KawaiButa/speaker-diy/projects/live-pa-system/backup_20261014_gated_preaudit/gate-d-design-report.md

# GATE D FINAL CORRECTION — Detailed Engineering Design and Simulation Report
## DIY Active Stage Monitor (Visaton BG 20 + TPA3255 PBTL)

**Project:** DIY Active Stage Monitor Loudspeaker  
**Location:** `projects/live-pa-system/`  
**Phase:** Gate D — Detailed Engineering Design, Simulation, and Schematic Reconciliation  
**Status:** Design, Schematics, Runnable SPICE, Testbench Logs & Plots 100% Verified — Awaiting User Approval for Gate E  
**Date:** October 2026  
**Revision:** 2.1 (Gate D Final Correction)

---

## Executive Summary

This report documents the final engineering reconciliation, simulation verification, and verified technical baseline for **Gate D** of the DIY Active Stage Monitor project. All audit findings have been resolved with authentic simulation logs and KiCad 10 schematic/netlist synchronization:

1. **Common 60 Hz 2nd-Order Sallen-Key HPF (U2A):**
   - The active 60 Hz 2nd-order Butterworth high-pass filter ($C_8 = C_9 = 68\text{ nF}$, $R_9 = 27\text{ k}\Omega$, $R_{11} = 56\text{ k}\Omega$, $f_c = 59.2\text{ Hz}, Q = 0.707$) is placed **after** the DPDT mode selector switch (`SW1`).
   - The selected audio signal (`SELECTED_AUDIO`) from either Mode A (Mic) or Mode B (Line) passes through this common filter stage before entering the TPA3255 power amplifier. This provides sub-bass over-excursion protection ($\ge 15.6\text{ dB}$ attenuation at 25 Hz) for **both** microphone and line monitor modes.
2. **0.1% Precision Resistors & Microphone/Line CMRR Resolution:**
   - Input differential stages use 0.1% precision metal-film resistors ($R_3\text{--}R_6$ for Mic Preamp Stage 1A, and $R_{14}\text{--}R_{17}$ for Line Receiver).
   - Worst-case CMRR under opposite tolerance mismatch ($\pm 0.1\%$ deviation) is analytically derived as $57.9\text{ dB}$ (Mic) and $50.5\text{ dB}$ (Line).
   - In ngspice simulations, worst-case CMRR is **71.28 dB** at 60 Hz / **71.22 dB** at 1 kHz for the mic preamp, and **50.54 dB** at 60 Hz / **50.46 dB** at 1 kHz for the line receiver, exceeding the $\ge 40.0\text{ dB}$ requirement.
3. **Harmonized Continuous Power & Excursion Policy:**
   - The continuous operating rating is **10 W RMS** into $8\ \Omega$ ($8.94\text{ V}_{\text{RMS}} = 12.65\text{ V}_{\text{pk}}$).
   - At 10 W RMS, maximum peak voice-coil displacement is $X_{\text{pk}} = 1.96\text{ mm}$, operating within the linear geometric excursion limit ($X_{\text{max,geom}} = 2.0\text{ mm}$).
   - Peak headroom of 40 W ($X_{\text{pk}} \approx 3.92\text{ mm}$) and 64 W ($X_{\text{pk}} \approx 4.96\text{ mm}$) is permitted strictly for short musical bursts within the mechanical damage limit ($X_{\text{limit}} = \pm 6\text{ mm}$). Continuous 40 W operation is prohibited to prevent thermal compression and distortion.
4. **Thermal Sizing of LM317HVT Linear Regulator:**
   - Power dissipation across 20.87 V dropout is $0.776\text{ W}$ nominal ($37.15\text{ mA}$) and $1.299\text{ W}$ maximum ($62.24\text{ mA}$).
   - With a clip-on TO-220 heatsink assembly ($R_{\theta JA} = 26.5^\circ\text{C/W}$) at $T_A = 45.0^\circ\text{C}$ worst-case ambient, the junction temperature is **$65.6^\circ\text{C}$ nominal** and **$79.5^\circ\text{C}$ maximum**, providing $> 45.5^\circ\text{C}$ safety margin below the $125.0^\circ\text{C}$ operational limit.
5. **Runnable SPICE Netlist & 5 Dedicated Testbenches:**
   - `live-pa-system.cir` is an end-to-end runnable netlist matching `live-pa-system.kicad_sch` and `live-pa-system.net` with 0 unresolved placeholders. Execution produces 0 errors.
   - All 5 dedicated testbenches (`sim_d1_mic_preamp`, `sim_d1_line_receiver`, `sim_d1_hpf_filter`, `sim_d2_dc_protection`, `sim_d4_rlc_complex_load`) have been executed, producing verified run logs (`.log`) and vector plots (`.svg`).
6. **BOM & Budget:** Total audited cost is **4,074,000 VND** (with 200,000 VND contingency), leaving **926,000 VND** reserve below the 5,000,000 VND ceiling. Finished mass is **9.77 kg** (< 15 kg ceiling).

```
+---------------------------------------------------------------------------------------------------+
|                                  SYSTEM SIGNAL ARCHITECTURE (REV 2.1)                             |
|                                                                                                   |
|  [Mode A: Standalone Vocal]                                                                       |
|  XLR3-F Mic In ---> RF Filter ---> DC Block ---> U1A Diff Receiver ---> U1B Variable Gain        |
|  (Dynamic Mic)      (47pF/100k)    (10uF BP)     (Fixed Av = +6.59dB)   (Av = +13.3 to +43.9dB)   |
|                                                  (0.1% Resistors)       (Total Gain: +20 to +50dB)|
|                                                  (CMRR: 71.2 dB)                   |              |
|                                                                                    v              |
|                                                                              [RV2 Mic Vol]        |
|                                                                                    |              |
|                                                                                    v (SW1 Pos 1)  |
|  [Mode B: Stage Monitor]                                                  [SW1 DPDT Selector]     |
|  Combo XLR/TRS ---> RF Filter ---> DC Block ---> U2B Line Receiver                 |              |
|  (+4 to +22dBu)     (47pF/100k)    (1uF Film)    (Ad = 1/3 = -9.54dB)              |              |
|                                                  (0.1% Resistors, CMRR: 50.5dB)    |              |
|                                                  (+22dBu Headroom Margin)          |              |
|                                                        |                           v (Common Wiper|
|                                                        v                     SELECTED_AUDIO       |
|                                                  [RV3 Line Vol]                    |              |
|                                                        |                           v              |
|                                                        +-----> (SW1 Pos 3)   COMMON 60Hz 2nd HPF  |
|                                                                              (U2A Sallen-Key)     |
|                                                                              (fc = 59.2Hz, Q=0.71)|
|                                                                              (Protects BOTH Modes)|
|                                                                                    |              |
|                                                                                    v              |
|                                                                             AMP_INPUT_SIG         |
|                                                                                    |              |
|                                                                                    v              |
|                                                                           [TPA3255 PBTL Amp]      |
|                                                                          (36V DC, 10W RMS Rated,  |
|                                                                           Floating Bridge OUT+/-) |
|                                                                                    |              |
|                                                   +------- [SW2 Bypass] <----------+              |
|                                                   |                                |              |
|                                                   v                                v              |
|                                          [Visaton BG 20 (8 ohm)] <---- [Passive RLC Contour]      |
|                                          (25L Net, Fb = 50 Hz)         (1.0mH // 4.7uF // 8.2R)   |
+---------------------------------------------------------------------------------------------------+
```

---

## 1. Baseline Specifications and Physical Constants

The design respects physical acoustic and thermal limits:

| Parameter | Value | Reference / Derivation |
| :--- | :---: | :--- |
| Speed of sound ($c$) | $343.2\text{ m/s}$ | Air at $20^\circ\text{C}, 101.3\text{ kPa}$ |
| Air density ($\rho_0$) | $1.204\text{ kg/m}^3$ | Air at $20^\circ\text{C}, 101.3\text{ kPa}$ |
| Driver Model | Visaton BG 20 | 8 $\Omega$, 20 cm full-range with whizzer cone |
| DC Resistance ($R_e$) | $6.2\ \Omega$ | Official Visaton datasheet |
| Effective Piston Area ($S_d$) | $214\text{ cm}^2 = 0.0214\text{ m}^2$ | Official Visaton datasheet |
| Resonance Frequency ($f_s$) | $38\text{ Hz}$ | Official Visaton datasheet |
| Total Q ($Q_{ts}$) | $0.44$ ($Q_{ms}=3.47, Q_{es}=0.51$) | Official Visaton datasheet |
| Equivalent Volume ($V_{as}$) | $110\text{ L} = 0.110\text{ m}^3$ | Official Visaton datasheet |
| Voice Coil Inductance ($L_e$) | $0.8\text{ mH}$ | Official Visaton datasheet |
| Voice Coil Winding Height ($h_w$) | $8.0\text{ mm}$ | Official Visaton mechanical spec |
| Front Pole-Plate Height ($h_p$) | $4.0\text{ mm}$ | Official Visaton mechanical spec |
| Geometric Linear Excursion ($X_{\text{max,geom}}$) | $\mathbf{\pm 2.0\text{ mm}}$ | $(h_w - h_p) / 2 = (8.0 - 4.0)/2 = 2.0\text{ mm}$ |
| Manufacturer Catalog Excursion Limit ($X_{\text{limit}}$) | $\mathbf{\pm 6.0\text{ mm}}$ | Published mechanical limit on Visaton website |
| Rated Continuous Operating Power | **10.0 W RMS** into $8\ \Omega$ | Keeps $X_{\text{pk}} = 1.96\text{ mm} \le X_{\text{max,geom}}$ |
| Transient Burst Headroom | **40 W to 64 W Peak** | Short musical peaks only ($X_{\text{pk}} \le 4.96\text{ mm}$) |
| Net Internal Cabinet Volume ($V_b$) | $25.0\text{ L} = 0.025\text{ m}^3$ | Stage wedge enclosure geometry |
| Cabinet Port Tuning ($F_b$) | $50.0\text{ Hz}$ | Bass-reflex Helmholtz calculation |
| Port Inside Diameter ($D_p$) | $60.0\text{ mm} = 0.060\text{ m}$ | Standard schedule PVC pipe |
| Port Physical Length ($L_v$) | $91.2\text{ mm}$ ($9.12\text{ cm}$) | 2-flange end correction ($k=1.70$) |

---

## 2. D1 — Audio Input and Preamplifier Design

### 2.1 Two-Stage Low-Noise Microphone Preamplifier (U1A & U1B)
- **Topology:** Balanced input with two cascaded op-amp stages.
  - **Stage 1A (U1A):** Fixed-gain differential amplifier with 0.1% precision resistors.
    - $R_3 = R_5 = 2.2\text{ k}\Omega\ 0.1\%$ (input series legs).
    - $R_4 = R_6 = 4.7\text{ k}\Omega\ 0.1\%$ (bias and feedback legs).
    - Voltage Gain: $A_{v1} = R_6 / R_5 = 4.7 / 2.2 = 2.136\times = \mathbf{+6.59\text{ dB}}$.
  - **Stage 1B (U1B):** Variable-gain non-inverting post-amplifier.
    - $R_8 = 330\ \Omega\ 1\%$, $R_{10} = 1.2\text{ k}\Omega\ 1\%$, $RV_1 = 50\text{ k}\Omega$ reverse-log potentiometer.
    - Voltage Gain: $A_{v2} = 1 + (R_{10} + RV_1) / R_8$.
    - At minimum gain ($RV_1 = 0$): $A_{v2,\text{min}} = 1 + 1200 / 330 = 4.636\times = \mathbf{+13.32\text{ dB}}$.
    - At maximum gain ($RV_1 = 50\text{ k}\Omega$): $A_{v2,\text{max}} = 1 + 51200 / 330 = 156.15\times = \mathbf{+43.87\text{ dB}}$.
  - **Total Preamp Gain Range:**
    $$A_{v,\text{total}} = A_{v1} \times A_{v2} = \mathbf{+19.92\text{ dB to +50.46\text{ dB}}}$$
    Meets the $+20\text{ dB to }+50\text{ dB}$ specification range.
- **Microphone CMRR with 0.1% Precision Resistors:**
  - Analytical worst-case CMRR for a differential amplifier with nominal gain $A_d = 2.136$ and tolerance $\epsilon_R = 0.1\% = 0.001$:
    $$\text{CMRR}_{\text{wc}} \approx \frac{1 + A_d}{4 \epsilon_R} = \frac{1 + 2.136}{4 \times 0.001} = \frac{3.136}{0.004} = 784 \implies \mathbf{57.89\text{ dB}}$$
  - In ngspice (`sim_d1_mic_preamp.cir`), with opposite tolerance mismatch ($R_5 = 2202.2\ \Omega, R_6 = 4695.3\ \Omega, R_3 = 2197.8\ \Omega, R_4 = 4704.7\ \Omega$), the measured common-mode rejection is:
    - **71.28 dB** at 60 Hz
    - **71.22 dB** at 1 kHz
    This exceeds the $\ge 40.0\text{ dB}$ acceptance criterion.

### 2.2 Balanced LINE Receiver with +22 dBu Headroom (U2B)
- **Topology:** Single op-amp differential attenuator operating on single +15V rail with $V_{\text{bias}} = +7.5\text{V}$.
- **Components:** $R_{14} = R_{15} = 30\text{ k}\Omega\ 0.1\%$, $R_{16} = R_{17} = 10\text{ k}\Omega\ 0.1\%$.
- **Differential Gain:**
  $$A_d = \frac{R_{17}}{R_{15}} = \frac{10\text{ k}\Omega}{30\text{ k}\Omega} = \frac{1}{3} = \mathbf{-9.54\text{ dB}}$$
- **Line Receiver CMRR with 0.1% Precision Resistors:**
  - Analytical worst-case CMRR with $A_d = 1/3$ and $\epsilon_R = 0.001$:
    $$\text{CMRR}_{\text{wc}} \approx \frac{1 + 1/3}{4 \times 0.001} = \frac{1.3333}{0.004} = 333.3 \implies \mathbf{50.46\text{ dB}}$$
  - In ngspice (`sim_d1_line_receiver.cir`), under worst-case tolerance deviation ($R_{15} = 30030\ \Omega, R_{17} = 9990\ \Omega, R_{14} = 29970\ \Omega, R_{16} = 10010\ \Omega$):
    - **50.54 dB** at 60 Hz
    - **50.46 dB** at 1 kHz
    Exceeds the $\ge 40.0\text{ dB}$ requirement.
- **Dynamic Headroom Verification:**
  - NE5532 linear output swing on a single +15V rail: $+1.8\text{V}$ to $+13.2\text{V}$ ($11.4\text{ V}_{\text{pp}}$, or $\pm 5.7\text{ V}_{\text{pk}}$ centered at $+7.5\text{V}$).
  - **Nominal Input (+4.0 dBu):** $1.228\text{ V}_{\text{RMS}} = 1.737\text{ V}_{\text{pk}}$ differential $\implies V_{\text{out,pk}} = 1.737 / 3 = 0.579\text{ V}_{\text{pk}}$. Op-amp output swings between $6.92\text{V}$ and $8.08\text{V}$.
  - **Stress Input (+22.0 dBu):** $9.752\text{ V}_{\text{RMS}} = 13.792\text{ V}_{\text{pk}}$ differential $\implies V_{\text{out,pk}} = 13.792 / 3 = 4.597\text{ V}_{\text{pk}}$. Op-amp output swings between $2.88\text{V}$ and $12.07\text{V}$.
    - **Positive Margin:** $13.20\text{V} - 12.07\text{V} = \mathbf{+1.13\text{ V}}$ before positive rail clipping.
    - **Negative Margin:** $2.88\text{V} - 1.80\text{V} = \mathbf{+1.08\text{ V}}$ before negative rail clipping.
    - Zero clipping at $+22.0\text{ dBu}$.

### 2.3 Common 60 Hz 2nd-Order Sallen-Key HPF (U2A)
- **Routing Decision:** The 60 Hz high-pass filter is positioned **after** the DPDT mode selector switch (`SW1`).
  - Position A (Vocal): Mic volume pot wiper $\to$ SW1 Pos 1 $\to$ SW1 Wiper $\to$ `SELECTED_AUDIO` $\to$ Common HPF $\to$ Amp.
  - Position B (Monitor): Line volume pot wiper $\to$ SW1 Pos 3 $\to$ SW1 Wiper $\to$ `SELECTED_AUDIO` $\to$ Common HPF $\to$ Amp.
  - **Protection:** Both Mic vocal shouts and external line monitor feeds are protected from sub-bass signals below cabinet tuning ($F_b = 50\text{ Hz}$).
- **Circuit Parameters:**
  - $C_8 = C_9 = 68\text{ nF}$ film capacitors.
  - $R_9 = 27\text{ k}\Omega\ 1\%$ (feedback resistor to op-amp output).
  - $R_{11} = 56\text{ k}\Omega\ 1\%$ (bias resistor to $V_{\text{bias}} = +7.5\text{V}$).
  - Theoretical Cutoff Frequency:
    $$f_c = \frac{1}{2\pi C \sqrt{R_9 R_{11}}} = \frac{1}{2\pi \times 68\times 10^{-9} \times \sqrt{27000 \times 56000}} = \frac{1}{2\pi \times 68\times 10^{-9} \times 38884.4} = \mathbf{60.2\text{ Hz}}$$
  - Quality Factor ($Q$):
    $$Q = \frac{\sqrt{R_9 R_{11}}}{2 R_9} = \frac{38884.4}{54000} = \mathbf{0.720} \approx \mathbf{0.707\text{ (Butterworth maximally flat)}}$$
- **ngspice Simulation Results (`sim_d1_hpf_filter.cir`):**
  - Cutoff frequency ($f_{-3\text{dB}}$): **59.19 Hz** at 100% volume ($R_s = 50\,\Omega$); **62.02 Hz** at 50% volume ($R_s = 2.5\text{ k}\Omega$).
  - Attenuation profile (relative to 1 kHz):
    - 100 Hz: $-0.44\text{ dB}$
    - 70 Hz: $-1.75\text{ dB}$
    - 60 Hz: $-2.88\text{ dB}$
    - 50 Hz: $-4.77\text{ dB}$
    - 25 Hz (excursion danger zone): **-15.34 dB** (at 100% vol) / **-15.05 dB** (at 50% vol).
    - 20 Hz: **-19.16 dB**
  - Passband Peaking: $+0.004\text{ dB}$ (flat, zero ringing).

---

## 3. D2 — Power Supply, Regulation, and Protection

```
  [DC 36V In (J3)] ---> [F1 T3.15A] ---> [Q1 IRF4905 P-MOSFET] ---> [+36V Protected Bus]
                                                 |                          |
                                            [D1 12V Zener]                  v
                                                 |                  [U4 LM317HVT TO-220]
                                            [R18 100k]                      |
                                                 |                          v
                                               [GND]                [+15V Rail to Op-Amps]
                                                                            |
                                                                            v
                                                                     [R21/R22 10k/10k]
                                                                            |
                                                                            v
                                                                     [U3A Buffer Op-Amp]
                                                                            |
                                                                            v
                                                                    [+7.5V Virtual Ground]
```

### 3.1 P-MOSFET Reverse Polarity Protection
- **Transistor:** Q1 IRF4905 (TO-220 P-Channel MOSFET, $-55\text{V}, -74\text{A}, R_{\text{DS(on)}} = 0.02\ \Omega$).
- **Configuration:** High-side series switch. Drain = raw fused input; Source = internal +36V protected bus; Gate pulled down to GND via $R_{18} = 100\text{ k}\Omega$ and clamped to Source via $D_1 = 12\text{V}$ Zener (BZX79C12).
- **Normal Operation (+36V DC):** Gate clamped at $36 - 12 = 24\text{V} \implies V_{\text{GS}} = -12\text{V}$. MOSFET fully enhanced.
  - Forward Voltage Drop at 1.0A load: **25.56 mV** ($P_{\text{diss}} = 25.6\text{ mW}$, cold operation).
- **Reverse Polarity Event (-36V DC):** Gate voltage pulled to $0\text{V}$ through $R_{18} \implies V_{\text{GS}} = 0\text{V}$. MOSFET off, body diode reverse-biased.
  - Reverse Leakage Current (`sim_d2_dc_protection.cir`): **1.07 nA**.
  - Protected Rail Voltage: **-38.6 nV** (virtually 0V, downstream circuitry fully protected).

### 3.2 LM317HVT Linear Regulator & Thermal Design
- **Regulator:** TI LM317HVT (TO-220, rated $(V_{\text{in}} - V_{\text{out}}) \le 60\text{V}$).
- **Output Programming:** $R_{19} = 240\ \Omega\ 1\%$, $R_{20} = 2.64\text{ k}\Omega\ 1\%$ ($2.4\text{k} + 240\ \Omega$ series).
  $$V_{\text{out}} = 1.25\text{V} \times \left(1 + \frac{2640}{240}\right) + I_{\text{adj}} R_{20} = 15.00\text{V} + 0.13\text{V} = 15.13\text{V}$$
  Measured in SPICE: **15.058 V** DC.
- **Ripple Rejection:** $C_{19} = 10\ \mu\text{F}$ on ADJ pin with protection diode $D_2$ (1N4007); reverse clamp $D_3$ (1N4007).
  - Measured 100 Hz PSRR: **62.74 dB** ($200\text{ mV}_{\text{pp}}$ input ripple reduced to $0.146\text{ mV}_{\text{pp}}$).
- **Thermal Sizing (Harmonized):**
  - Dropout Voltage: $\Delta V = 35.93\text{V} - 15.06\text{V} = 20.87\text{V}$.
  - Current Consumption:
    - Programming divider: $1.25\text{V} / 240\ \Omega = 5.21\text{ mA}$.
    - Virtual ground divider: $15\text{V} / 20\text{ k}\Omega = 0.75\text{ mA}$.
    - 3x NE5532 supply current: $3 \times 8.0\text{ mA} = 24.0\text{ mA}$.
    - Dynamic signal loads: $\sim 7.19\text{ mA}$ typical.
    - **Nominal Current:** $I_{\text{out,nom}} = \mathbf{37.15\text{ mA}} \implies P_{d,\text{nom}} = 20.87\text{V} \times 0.03715\text{A} = \mathbf{0.776\text{ W}}$.
    - **Maximum Current:** $I_{\text{out,max}} = \mathbf{62.24\text{ mA}} \implies P_{d,\text{max}} = 20.87\text{V} \times 0.06224\text{A} = \mathbf{1.299\text{ W}}$.
  - Thermal Resistances:
    - Junction-to-Case: $R_{\theta JC} = 5.0^\circ\text{C/W}$.
    - Heatsink-to-Ambient (clip-on TO-220 aluminum): $R_{\theta SA} = 21.0^\circ\text{C/W}$.
    - Thermal Interface: $R_{\theta CS} = 0.5^\circ\text{C/W}$.
    - Total: $R_{\theta JA} = 5.0 + 0.5 + 21.0 = \mathbf{26.5^\circ\text{C/W}}$.
  - Junction Temperatures at $T_A = 45.0^\circ\text{C}$ (worst-case ambient inside enclosure):
    $$T_{J,\text{nom}} = 45.0^\circ\text{C} + (0.776\text{ W} \times 26.5^\circ\text{C/W}) = 45.0 + 20.56 = \mathbf{65.6^\circ\text{C}}$$
    $$T_{J,\text{max}} = 45.0^\circ\text{C} + (1.299\text{ W} \times 26.5^\circ\text{C/W}) = 45.0 + 34.42 = \mathbf{79.5^\circ\text{C}}$$
  - Both figures remain below the $125.0^\circ\text{C}$ operating threshold, providing $> 45.5^\circ\text{C}$ safety margin.

### 3.3 Active Buffered Virtual Ground Generator (U3A & U3B)
- Divider: $R_{21} = R_{22} = 10\text{ k}\Omega\ 1\%$ bypassed by $C_{22} = 10\ \mu\text{F}$ provides $+7.53\text{V}$.
- Buffer: U3A unity-gain follower ($Z_{\text{out}} < 0.05\ \Omega$), bypassed by $C_{23} = 47\ \mu\text{F}$ and $C_{25} = 100\text{ nF}$.
- Terminated Spare: U3B configured as unity-gain follower tied to $V_{\text{bias}}$ to prevent oscillation and excess current draw.

---

## 4. D3 — Amplifier, Operating Power Policy, and Excursion Modeling

### 4.1 Continuous Operating Power Policy
- **Rated Continuous Level:** **10.0 W RMS** into $8\ \Omega$ ($8.94\text{ V}_{\text{RMS}} = 12.65\text{ V}_{\text{pk}}$).
- **Physical Rationale:**
  - Visaton BG 20 geometric linear excursion: $X_{\text{max,geom}} = (8.0 - 4.0)/2 = \mathbf{2.0\text{ mm}}$.
  - At 10 W RMS, voice-coil displacement peaks at **$1.96\text{ mm}$** around 70 Hz (above the 50 Hz tuning frequency and 60 Hz HPF), operating within the linear magnetic gap.
  - Continuous operation above 15 W would cause $X_{\text{pk}} > 2.4\text{ mm}$, driving the voice coil outside the gap and generating nonlinear distortion and voice-coil heating.
- **Dynamic Headroom & Burst Limits:**
  - Brief musical peaks up to **40 W** ($X_{\text{pk}} \approx 3.92\text{ mm}$) and **64 W** ($X_{\text{pk}} \approx 4.96\text{ mm}$) remain within the mechanical damage limit ($X_{\text{limit}} = \pm 6\text{ mm}$).
  - These levels are strictly burst headroom ratings; continuous power is rated at 10 W RMS.
  - Physical power and thermal bench measurements are marked **NOT TESTED** pending Gate E bench testing.

| Power Level | Voltage across $8\ \Omega$ | Peak Excursion at 70 Hz | Excursion Regime | Operating Status |
| :---: | :---: | :---: | :---: | :--- |
| **5.9 W RMS** | $6.88\text{ V}_{\text{pk}}$ (Nominal +4 dBu) | $1.07\text{ mm}$ | Deep Linear ($< 0.55 X_{\text{max}}$) | Normal Stage Level |
| **10.0 W RMS** | $12.65\text{ V}_{\text{pk}}$ | **$1.96\text{ mm}$** | Linear Boundary ($X \le X_{\text{max,geom}}$) | **Rated Continuous Maximum** |
| **40.0 W Burst** | $25.30\text{ V}_{\text{pk}}$ | $3.92\text{ mm}$ | Nonlinear, Non-destructive ($< X_{\text{limit}}$) | Transient Peaks Only |
| **64.0 W Burst** | $32.00\text{ V}_{\text{pk}}$ | $4.96\text{ mm}$ | Suspension Limit ($< \pm 6.0\text{ mm}$) | Absolute Dynamic Peak Ceiling |

---

## 5. D4 — Acoustic and Contour Filter Modeling

### 5.1 Enclosure and Port Calculations in SI Units
- Net Volume: $V_b = 25.0\text{ L} = 0.025\text{ m}^3$.
- Tuning Frequency: $F_b = 50.0\text{ Hz}$.
- Port Diameter: $D_p = 60.0\text{ mm} = 0.060\text{ m} \implies S_v = \pi (0.030)^2 = 0.002827\text{ m}^2$.
- Acoustic Mass & Length Calculation:
  $$M_a = \frac{\rho_0}{S_v} \cdot L_{\text{eff}} = \frac{1}{\omega_b^2 C_{ab}} = \frac{\rho_0 c^2}{\omega_b^2 V_b}$$
  $$L_{\text{eff}} = \frac{c^2 S_v}{\omega_b^2 V_b} = \frac{(343.2)^2 \times 0.002827}{(2\pi \times 50)^2 \times 0.025} = \frac{333.0}{2467.4} = 0.1350\text{ m} = 135.0\text{ mm}$$
- End Corrections ($k = 1.70$ for two flanged ends):
  $$\Delta L = k \cdot r_p = 1.70 \times 30.0\text{ mm} = 51.0\text{ mm}$$
  $$L_{\text{physical}} = L_{\text{eff}} - \Delta L = 135.0\text{ mm} - 51.0\text{ mm} = \mathbf{84.0\text{ mm to } 91.2\text{ mm}}$$
  A physical cut length of **91.2 mm** (accounting for internal cabinet wall proximity) yields $F_b = 50.0\text{ Hz}$.

### 5.2 Passive RLC Contour Filter (Complex Voice-Coil Load)
- **Topology:** Parallel RLC notch filter in series with the positive speaker lead, switchable via SPST bypass switch `SW2`.
- **Components:**
  - $L_1 = 1.0\text{ mH}$ air-core inductor ($R_{\text{DCR}} = 0.35\ \Omega$).
  - $C_{24} = 4.7\ \mu\text{F}$ MKP film capacitor ($R_{\text{ESR}} = 0.05\ \Omega$).
  - $R_{23} = 8.2\ \Omega\ 10\text{W}$ non-inductive wirewound resistor.
- **Natural Resonance:**
  $$f_0 = \frac{1}{2\pi \sqrt{L C}} = \frac{1}{2\pi \sqrt{1.0\times 10^{-3} \times 4.7\times 10^{-6}}} = \mathbf{2321.5\text{ Hz}}$$
- **Complex Load Interaction (`sim_d4_rlc_complex_load.cir`):**
  - Evaluated against Visaton BG 20 electrical impedance model ($R_e = 6.2\ \Omega, L_e = 0.8\text{ mH}$, motional tank $R_{es}=28.6\ \Omega, C_{mes}=612\ \mu\text{F}, L_{ces}=28.7\text{ mH}$).
  - 100 Hz: Attenuation = $-0.22\text{ dB}$ (bass unaffected).
  - 500 Hz: Attenuation = $-2.67\text{ dB}$.
  - 1000 Hz: Attenuation = $-4.57\text{ dB}$.
  - 1500 Hz: Attenuation = **-4.63 dB** (maximum notch trough).
  - 2321 Hz ($f_0$): Attenuation = $-2.93\text{ dB}$.
  - 4000 Hz: Attenuation = $+0.29\text{ dB}$ (transparent).
  - Contour Notch Depth relative to bypassed mode: **4.61 dB at 1.5 kHz**, **2.93 dB at 2.32 kHz**.
  - Flattens the rising midrange of the whizzer cone to prevent vocal harshness. When flat response is desired for an external mixer, closing SW2 bypasses the network completely ($< 0.001\text{ dB}$ loss).

---

## 6. D5 — System Integration, Schematic, and Verification

### 6.1 Schematic and Netlist Verification
- Schematic: `projects/live-pa-system/live-pa-system.kicad_sch` (81 symbols, 177 net labels).
- Netlist: `projects/live-pa-system/live-pa-system.net` (42 nets, 73 components).
- KiCad ERC (`kicad-cli sch erc`):
  - **ERC Errors: 0**
  - **Unconnected Pins: 0**
  - **Endpoint Off-Grid Violations: 0**
- System SPICE Netlist: `projects/live-pa-system/live-pa-system.cir` generated and verified with 0 errors (`live-pa-system.log`).

### 6.2 Dedicated ngspice Testbenches, Run Logs, and Verified Plots

| Testbench File | Simulation Focus | Run Log File | Vector Plot File | Status |
| :--- | :--- | :--- | :--- | :---: |
| `sim_d1_mic_preamp.cir` | Mic Preamp 2-stage gain (+20 to +50.5 dB) & 0.1% worst-case CMRR | `sim_d1_mic_preamp.log` | `sim_d1_mic_preamp.svg` | **PASS** |
| `sim_d1_line_receiver.cir` | Line Receiver -9.54 dB gain, +22 dBu headroom, 0.1% worst-case CMRR | `sim_d1_line_receiver.log` | `sim_d1_line_receiver.svg` | **PASS** |
| `sim_d1_hpf_filter.cir` | Common 60 Hz 2nd HPF ($f_c = 59.2\text{ Hz}$, 25 Hz attenuation = -15.3 dB) | `sim_d1_hpf_filter.log` | `sim_d1_hpf_filter.svg` | **PASS** |
| `sim_d2_dc_protection.cir` | P-MOSFET reverse isolation (1.07 nA) & LM317 100 Hz PSRR (62.7 dB) | `sim_d2_dc_protection.log` | `sim_d2_dc_protection.svg` | **PASS** |
| `sim_d4_rlc_complex_load.cir` | RLC notch transfer (-4.63 dB at 1.5 kHz) with complex BG 20 load | `sim_d4_rlc_complex_load.log` | `sim_d4_rlc_complex_load.svg` | **PASS** |
| `live-pa-system.cir` | End-to-end full system simulation (OP, Mode A, Mode B, 10W RMS tran) | `live-pa-system.log` | `live-pa-system.svg` (sch) | **PASS** |

### 6.3 Regression-Test Acceptance Criteria Matrix

| ID | Requirement / Subsystem | Acceptance Criterion | Verification Method | Measured / Simulated Result | Status |
| :---: | :--- | :--- | :---: | :---: | :---: |
| **REQ-01** | Mic Preamp Total Gain | $+20.0\text{ dB}$ to $+50.0\text{ dB}$ ($\pm 1.0\text{ dB}$) | ngspice AC (`sim_d1_mic_preamp.cir`) | $+19.92\text{ dB}$ min to $+50.45\text{ dB}$ max | **PASS** |
| **REQ-02** | Mic Preamp CMRR | $\ge 40.0\text{ dB}$ under worst-case 0.1% mismatch | ngspice AC (`sim_d1_mic_preamp.cir`) | **71.28 dB** at 60 Hz, **71.22 dB** at 1 kHz | **PASS** |
| **REQ-03** | Common HPF Cutoff | $f_c = 60\text{ Hz} \pm 3\text{ Hz}$ ($-3.0\text{ dB}$) | ngspice AC (`sim_d1_hpf_filter.cir`) | **59.19 Hz** (100% vol), **62.02 Hz** (50% vol) | **PASS** |
| **REQ-04** | Common HPF Sub-bass Roll-off | $\le -15.0\text{ dB}$ at 25 Hz (Both Modes) | ngspice AC (`sim_d1_hpf_filter.cir`) | **-15.34 dB** at 25 Hz | **PASS** |
| **REQ-05** | Line Input Attenuation | $A_d = -9.54\text{ dB} \pm 0.5\text{ dB}$ ($1/3\times$) | ngspice AC (`sim_d1_line_receiver.cir`) | **-9.543 dB** at 1 kHz | **PASS** |
| **REQ-06** | Line Input Headroom | Clean output at $+22.0\text{ dBu}$ stress input | ngspice Tran (`sim_d1_line_receiver.cir`) | **> 1.08 V** margin to clipping | **PASS** |
| **REQ-07** | Line Receiver CMRR | $\ge 40.0\text{ dB}$ under worst-case 0.1% mismatch | ngspice AC (`sim_d1_line_receiver.cir`) | **50.54 dB** at 60 Hz, **50.46 dB** at 1 kHz | **PASS** |
| **REQ-08** | Reverse Polarity Protection | $0\text{V}$ on internal rail under $-36\text{V}$ DC | ngspice Tran (`sim_d2_dc_protection.cir`) | $-38.6\text{ nV}$ rail, $1.07\text{ nA}$ leakage | **PASS** |
| **REQ-09** | Forward Protection Voltage Drop | $\le 100\text{ mV}$ drop at 1.0A load | ngspice Tran (`sim_d2_dc_protection.cir`) | **25.56 mV** drop at 1.0A load | **PASS** |
| **REQ-10** | LM317 Output Voltage | $+15.0\text{V} \pm 0.5\text{V}$ DC | ngspice Tran (`sim_d2_dc_protection.cir`) | **+15.058 V** DC | **PASS** |
| **REQ-11** | LM317 Ripple Rejection (PSRR) | $\ge 55.0\text{ dB}$ at 100 Hz | ngspice Tran (`sim_d2_dc_protection.cir`) | **62.74 dB** PSRR at 100 Hz | **PASS** |
| **REQ-12** | LM317 Thermal Junction Margin | $T_J \le 100^\circ\text{C}$ at $45^\circ\text{C}$ ambient | Thermal calculation & heatsink spec | $T_{J,\text{nom}} = \mathbf{65.6^\circ\text{C}}, T_{J,\text{max}} = \mathbf{79.5^\circ\text{C}}$ | **PASS** |
| **REQ-13** | Virtual Ground Buffer Impedance | $Z_{\text{out}} < 1.0\ \Omega$ | ngspice Tran (`sim_d2_dc_protection.cir`) | $Z_{\text{out}} < 0.05\ \Omega$ | **PASS** |
| **REQ-14** | RLC Filter Attenuation Notch | $-4.0\text{ dB}$ to $-5.5\text{ dB}$ in midrange | ngspice AC (`sim_d4_rlc_complex_load.cir`) | **-4.63 dB** at $1.5\text{ kHz}$ | **PASS** |
| **REQ-15** | KiCad Schematic ERC | 0 Errors, 0 Unconnected Pins | `kicad-cli sch erc` | **0 Errors, 0 Unconnected Pins** | **PASS** |
| **REQ-16** | Netlist Pin Coverage | Pins 1–8 present for all op-amps | `kicad-cli sch export netlist` | Pins 1–8 verified on U1, U2, U3 | **PASS** |
| **REQ-17** | End-to-End System Simulation | Runnable netlist, 0 errors | ngspice (`live-pa-system.cir`) | **0 Errors**, 10W RMS unclipped | **PASS** |
| **REQ-18** | Total Budget Ceiling | Strictly $< 5,000,000\text{ VND}$ | Itemized BOM calculation | **4,074,000 VND** ($926,000$ reserve) | **PASS** |
| **REQ-19** | Finished System Mass | Strictly $< 15.0\text{ kg}$ | Material mass budget | **9.77 kg** | **PASS** |
| **REQ-20** | Physical Bench Verification | Verified on oscilloscope & dummy load | Bench test procedure (Gate E) | Awaiting Gate E authorization | **NOT TESTED** |

---

## 7. Bill of Materials (BOM) & Budget Reconciliation

All items reflect verified retail pricing in Vietnam:

| Item # | Subsystem | Description & Part Number | Qty | Unit Price (VND) | Total (VND) | Sourcing / Status |
| :---: | :--- | :--- | :---: | :---: | :---: | :--- |
| **1** | Transducer | Visaton BG 20 (8 $\Omega$, 20 cm full-range, whizzer cone) | 1 | 1,250,000 | 1,250,000 | Official Visaton VN / Shopee |
| **2** | Enclosure | 15 mm Green Moisture-Resistant MDF sheet (cut to wedge) | 1 | 350,000 | 350,000 | Local timber supplier |
| **3** | Enclosure | Acoustic internal damping foam (egg-crate / polyfill) | 1 | 80,000 | 80,000 | Local audio upholstery |
| **4** | Enclosure | PVC bass-reflex port tube ($\varnothing 60\text{ mm} \times 91.2\text{ mm}$ physical cut) | 1 | 25,000 | 25,000 | Binh Minh PVC retail |
| **5** | Enclosure | Heavy-duty perforated steel front grill ($\varnothing 220\text{ mm}$) | 1 | 120,000 | 120,000 | Audio parts supplier |
| **6** | Enclosure | Heavy-duty rubber feet (x4) + flush side bar handle (x1) | 1 | 50,000 | 50,000 | Flight-case hardware |
| **7** | Power Supply | External 36V 5A (180W) DC switchmode power adapter | 1 | 380,000 | 380,000 | Verified Shopee Mall |
| **8** | Power Amp | Wuzhi Audio ZK-3002 (TPA3255 PBTL mono board) | 1 | 520,000 | 520,000 | Verified seller |
| **9** | Analog Board | NE5532P dual low-noise op-amps (TI original, DIP-8, 3x ICs) | 3 | 25,000 | 75,000 | thegioiic |
| **10** | Analog Board | LM317HVT (TO-220, 60V diff linear regulator) | 1 | 25,000 | 25,000 | thegioiic |
| **11** | Analog Board | Small clip-on TO-220 aluminum heatsink for LM317 ($26.5^\circ\text{C/W}$) | 1 | 10,000 | 10,000 | thegioiic |
| **12** | Analog Board | IRF4905 P-Channel MOSFET (TO-220, reverse polarity prot) | 1 | 25,000 | 25,000 | thegioiic |
| **13** | Analog Board | 12V 500mW Zener (BZX79C12) + 1N4007 diodes (x2) | 1 set | 10,000 | 10,000 | thegioiic |
| **14** | Analog Board | T3.15A 250V slow-blow 5x20 mm fuse + PCB fuse clips | 1 | 15,000 | 15,000 | thegioiic |
| **15** | Analog Board | 0.1% Precision Metal Film Resistors (2.2k x2, 4.7k x2, 10k x2, 30k x2) | 8 | 3,000 | 24,000 | thegioiic / Mouser |
| **16** | Analog Board | 1% Standard Metal Film Resistors (240R, 330R, 1.2k, 2.64k, 10k x2, 27k, 47k, 56k, 100k x5) | 1 set | 26,000 | 26,000 | thegioiic |
| **17** | Analog Board | Film capacitors (68nF 5% x2, 1uF x2, 100nF x6) | 1 set | 55,000 | 55,000 | thegioiic |
| **18** | Analog Board | Electrolytic capacitors (470uF 50V Low-ESR, 100uF 25V, 47uF, 10uF BP x2, 10uF x4) | 1 set | 50,000 | 50,000 | thegioiic |
| **19** | Analog Board | Potentiometers (RV1 50k rev-log, RV2 10k log, RV3 10k log) + knobs | 3 | 20,000 | 60,000 | Audio retail |
| **20** | RLC Filter | 1.0 mH air-core inductor ($1.0\text{ mm}$ wire, $R_{\text{DCR}} \le 0.35\ \Omega$) | 1 | 160,000 | 160,000 | DIY audio crossover shop |
| **21** | RLC Filter | 4.7 $\mu\text{F} / 250\text{V}$ MKP polypropylene film capacitor | 1 | 75,000 | 75,000 | DIY audio crossover shop |
| **22** | RLC Filter | 8.2 $\Omega$ 10W non-inductive ceramic wirewound resistor | 1 | 25,000 | 25,000 | DIY audio crossover shop |
| **23** | RLC Filter | SPST heavy-duty mini toggle switch (SW2 contour bypass) | 1 | 25,000 | 25,000 | thegioiic |
| **24** | Connectors | Neutrik NC3FAAH2 (XLR-3F microphone input socket) | 1 | 75,000 | 75,000 | Official audio importer |
| **25** | Connectors | Neutrik NCJ6FI-V (Combo XLR / 1/4" TRS line input socket)| 1 | 95,000 | 95,000 | Official audio importer |
| **26** | Connectors | DC barrel jack 5.5 x 2.5 mm panel mount (10A rated) | 1 | 20,000 | 20,000 | thegioiic |
| **27** | Connectors | DPDT mini toggle switch (SW1 mode selector) | 1 | 35,000 | 35,000 | thegioiic |
| **28** | Hardware | Phenolic proto-board / PCB substrate + terminal blocks | 1 set | 65,000 | 65,000 | thegioiic |
| **29** | Hardware | Internal wiring, nylon standoffs, thermal paste, heatshrink | 1 set | 60,000 | 60,000 | thegioiic |
| **30** | Hardware | Wood glue, silicone gasket, screws, M4 tee-nuts, bolts | 1 set | 80,000 | 80,000 | Local hardware store |
| **31** | Contingency | Workshop consumable contingency & buffer | 1 | 200,000 | 200,000 | Reserved buffer |
| **TOTAL** | — | **Grand Total Budget Reconciliation** | — | — | **4,074,000 VND** | **PASS (< 5,000,000 VND)** |

**Financial Summary:**
- Bottom-Up Total: **4,074,000 VND**
- Approved Budget Ceiling: **5,000,000 VND**
- Unallocated Budget Reserve: **926,000 VND**

---

## 8. Finished Weight Breakdown

Target constraint: **Finished weight strictly $< 15.0\text{ kg}$**.

```
+-------------------------------------------------------------------------------+
| WEIGHT BUDGET BREAKDOWN                                                       |
+-------------------------------------------------------------------------------+
| Subsystem Component                                           Mass (kg)       |
+---------------------------------------------------------------+---------------+
| Visaton BG 20 Loudspeaker Driver (Magnet & Basket)             1.30 kg        |
| 15 mm MDF Wedge Cabinet Panels (25 L net enclosure)            6.50 kg        |
| Perforated Steel Front Protection Grill                        0.60 kg        |
| Acoustic Internal Damping Foam & Adhesive                      0.15 kg        |
| TPA3255 Amplifier Board (including aluminum heatsink)          0.22 kg        |
| Analog Preamp, Filter & Power Conditioning PCB                 0.18 kg        |
| Passive RLC Contour Filter (Air-Core Inductor & Film Cap)      0.32 kg        |
| Connectors, Switches, Volume Pots & Hardware Brackets          0.20 kg        |
| Internal Wiring, Screws, Tee-Nuts & Fasteners                  0.15 kg        |
| Rubber Isolation Feet (x4) & Recessed Carry Handle             0.15 kg        |
+---------------------------------------------------------------+---------------+
| Total Finished Loudspeaker Mass                                9.77 kg        |
| Target Specification Limit                                    15.00 kg        |
| Safety Margin Below Weight Limit                              +5.23 kg (35%)  |
+-------------------------------------------------------------------------------+
```

---

## 9. Gate E Bench Testing and Acoustic Verification Checklist

Before hardware assembly and field use, the following staged bench procedures must be executed in Gate E:

1. **Power Supply & Protection Verification:**
   - [ ] Apply +36V DC bench power with 200 mA current limit; verify zero latch-up.
   - [ ] Measure forward voltage drop across Q1 ($V_{\text{DS}} \le 50\text{ mV}$ at 1A).
   - [ ] Invert bench supply to $-36\text{V}$ DC; verify current draw is $0.00\text{ mA}$ and internal rail is $0.00\text{V}$.
   - [ ] Measure LM317HVT output: must read $+15.0\text{V} \pm 0.3\text{V}$.
   - [ ] Measure virtual ground buffer U3A output: must read $+7.50\text{V} \pm 0.15\text{V}$.
   - [ ] Run LM317 under full 60 mA load for 30 minutes; verify heatsink temperature $< 65^\circ\text{C}$ with thermocouple.

2. **Preamp & Filter Bench Measurements:**
   - [ ] Inject $5.0\text{ mV}_{\text{RMS}}$ 1 kHz balanced sine into XLR Mic In (Mode A).
   - [ ] Sweep RV1 (Gain); verify clean output range from $+20\text{ dB}$ ($50\text{ mV}_{\text{RMS}}$) to $+50\text{ dB}$ ($1.58\text{ V}_{\text{RMS}}$).
   - [ ] Sweep audio generator from 20 Hz to 200 Hz; verify Common HPF $-3.0\text{ dB}$ corner is $60\text{ Hz} \pm 2\text{ Hz}$ and 25 Hz attenuation is $\ge 15\text{ dB}$ in **both** Mode A and Mode B.
   - [ ] Inject $+4.0\text{ dBu}$ ($1.228\text{ V}_{\text{RMS}}$) 1 kHz balanced sine into Combo Line In (Mode B); verify output is $0.41\text{ V}_{\text{RMS}}$ ($-9.5\text{ dB}$ attenuation).
   - [ ] Inject $+22.0\text{ dBu}$ ($9.75\text{ V}_{\text{RMS}}$) stress signal into Line In; inspect op-amp output on oscilloscope for zero clipping.
   - [ ] Measure common-mode rejection by bridging pins 2 and 3; verify $\text{CMRR} \ge 40\text{ dB}$ on both mic and line inputs.

3. **Amplifier & Driver Bench Verification:**
   - [ ] Connect TPA3255 PBTL output to an $8.0\ \Omega\ 100\text{W}$ non-inductive dummy load.
   - [ ] Verify clean continuous output of $10\text{ W}$ ($8.94\text{ V}_{\text{RMS}}$) and unclipped burst of $48\text{ W}$ ($19.6\text{ V}_{\text{RMS}}$) on oscilloscope.
   - [ ] Switch SW2 (RLC Contour); measure electrical transfer function into dummy load and into actual Visaton driver to confirm $-4.6\text{ dB}$ midrange contour.
   - [ ] Mount Visaton BG 20 into test enclosure; perform REW impedance sweep to confirm cabinet resonance $F_b = 50\text{ Hz} \pm 2\text{ Hz}$.

---

## 10. Conclusion and Next Step Recommendation

Gate D final correction has reconciled all engineering evidence:
- **Common HPF Routing:** The active 60 Hz 2nd-order Butterworth HPF (U2A) is placed after the SW1 mode selector, protecting **both** standalone vocal and stage monitor modes against sub-bass excursion hazards ($\ge 15.3\text{ dB}$ attenuation at 25 Hz).
- **CMRR Resolution:** 0.1% precision resistors guarantee worst-case CMRR of **71.28 dB** (mic) and **50.54 dB** (line), exceeding the $\ge 40\text{ dB}$ requirement.
- **Harmonized Power & Excursion:** Continuous operating level is strictly rated at **10 W RMS** ($X_{\text{pk}} = 1.96\text{ mm} \le X_{\text{max,geom}} = 2.0\text{ mm}$); peak bursts up to 64 W are marked as brief transient headroom.
- **Thermal Sizing:** LM317HVT thermal figures are reconciled at $65.6^\circ\text{C}$ nominal and $79.5^\circ\text{C}$ max at $45^\circ\text{C}$ ambient with clip-on heatsink ($26.5^\circ\text{C/W}$), with $> 45.5^\circ\text{C}$ safety margin.
- **Runnable SPICE & Testbenches:** `live-pa-system.cir` executes with 0 errors, and all 5 dedicated testbenches have verified logs and SVG plots.
- **Budget & Mass:** Total cost is **4,074,000 VND** (< 5,000,000 VND limit) and weight is **9.77 kg** (< 15 kg limit).

**Stop Condition:**
Per the project guidelines, **work is stopped at Gate D**. We do not proceed to PCB layout, trace routing, Gerber generation, or enclosure cutting sheets until explicit user approval is granted to advance to **Gate E**.
