KawaiButa/speaker-diy/projects/live-pa-system/backup_20261015_pre_perfboard_redesign/live-pa-system-board-3d.png

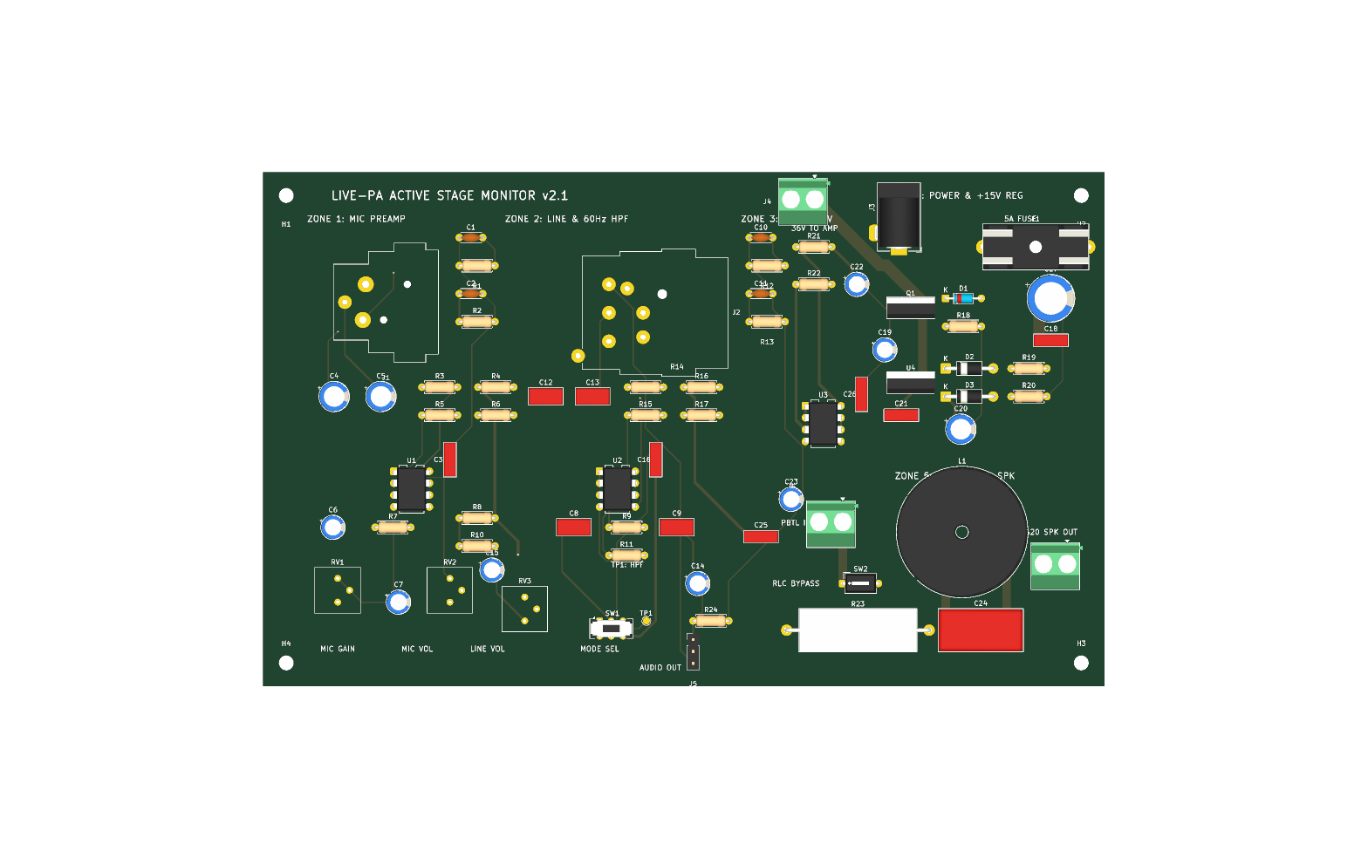
projects/live-pa-system/backup_20261015_pre_perfboard_redesign/live-pa-system-board-3d.png
