KawaiButa/speaker-diy/projects/live-pa-system/live-pa-system-board-3d-bottom.png

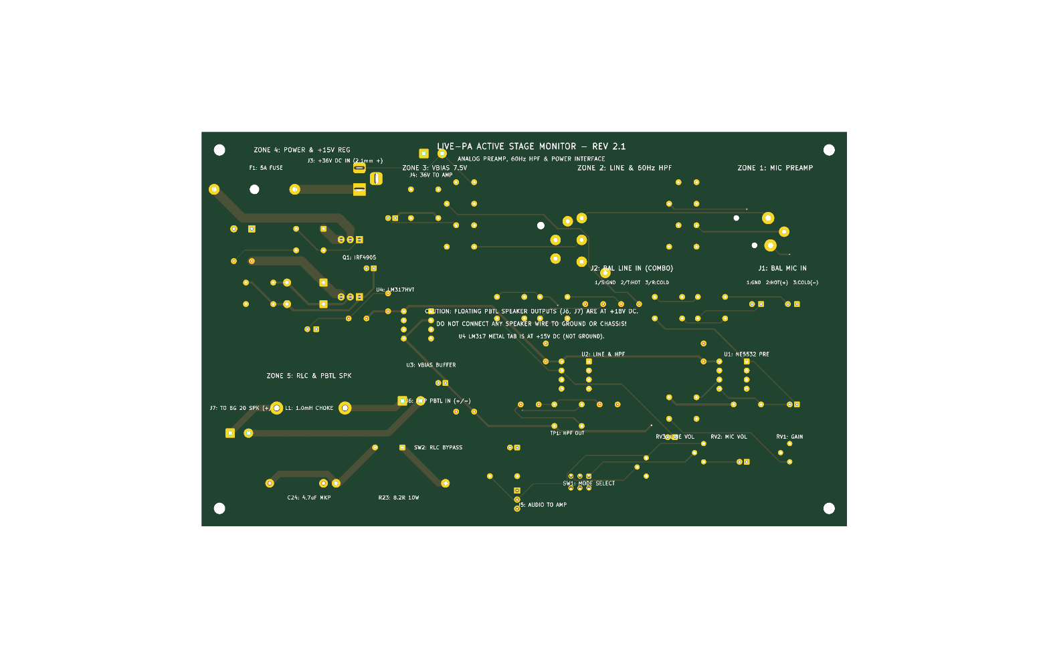
projects/live-pa-system/live-pa-system-board-3d-bottom.png
