KawaiButa/speaker-diy/projects/live-pa-system/backup_20261015_pre_phased_plan/live-pa-system.kicad_pcb

## KiCad design projects/live-pa-system/backup_20261015_pre_phased_plan/live-pa-system.kicad_pcb (2026-10-15)

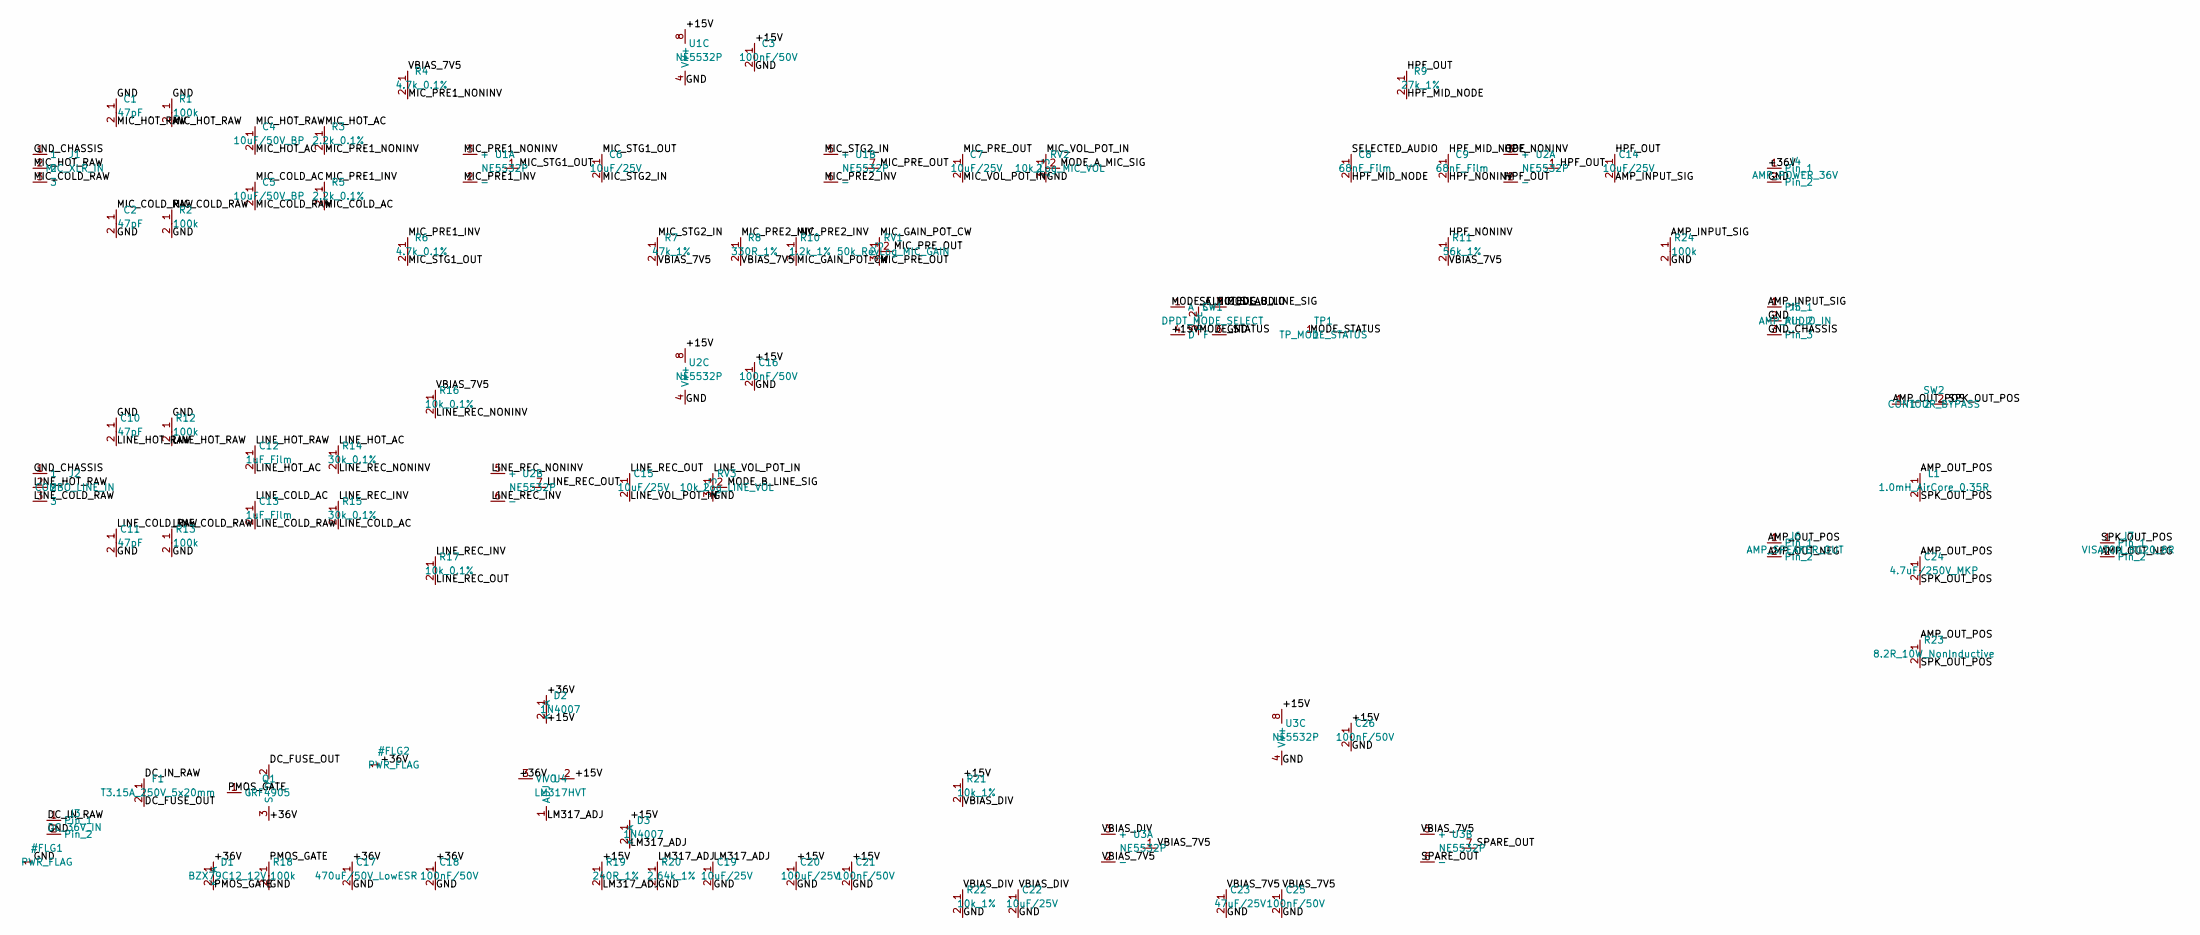
[picture p3: schematic live-pa-system.kicad_sch, DIY Active Stage Monitor - Analog Front-End & Filter]

Parts:
C1, C2, C10, C11: 47pF; C_Disc_D4.3mm_W1.9mm_P5.00mm
C3, C16, C18, C21, C25, C26: 100nF/50V; C_Rect_L7.2mm_W2.5mm_P5.00mm_FKS2_FKP2_MKS2_MKP2
C4, C5: 10uF/50V_BP; CP_Radial_D6.3mm_P2.50mm
C6, C7, C14, C15, C19, C22: 10uF/25V; CP_Radial_D5.0mm_P2.00mm
C8, C9: 68nF_Film; C_Rect_L7.2mm_W3.5mm_P5.00mm_FKS2_FKP2_MKS2_MKP2
C12, C13: 1uF_Film; C_Rect_L7.2mm_W3.5mm_P5.00mm_FKS2_FKP2_MKS2_MKP2
C17: 470uF/50V_LowESR; CP_Radial_D10.0mm_P5.00mm
C20: 100uF/25V; CP_Radial_D6.3mm_P2.50mm
C23: 47uF/25V; CP_Radial_D5.0mm_P2.00mm
C24: 4.7uF/250V_MKP; C_Rect_L18.0mm_W9.0mm_P15.00mm_FKS3_FKP3
D1: BZX79C12_12V; D_DO-35_SOD27_P7.62mm_Horizontal
D2, D3: 1N4007; D_DO-41_SOD81_P10.16mm_Horizontal
F1: T3.15A_250V_5x20mm; Fuseholder_Cylinder-5x20mm_Schurter_0031_8201_Horizontal_Op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
J1: MIC_XLR_IN; Jack_XLR_Neutrik_NC3FAH_Horizontal
J2: COMBO_LINE_IN; Jack_XLR-6.35mm_Neutrik_NCJ6FI-H_Horizontal
J3: DC_36V_IN; BarrelJack_Horizontal
J4: AMP_POWER_36V; TerminalBlock_Phoenix_MKDS-1,5-2-5.08_1x02_P5.08mm_Horizont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
J5: AMP_AUDIO_IN; PinHeader_1x03_P2.54mm_Vertical
J6: AMP_SPEAKER_OUT; TerminalBlock_Phoenix_MKDS-1,5-2-5.08_1x02_P5.08mm_Horizont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
J7: VISATON_BG20_8R; TerminalBlock_Phoenix_MKDS-1,5-2-5.08_1x02_P5.08mm_Horizont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
L1: 1.0mH_AirCore_0.35R; L_Radial_D27.9mm_P19.05mm_Vishay_IHB-3
Q1: IRF4905; TO-220-3_Vertical
R1, R2, R12, R13, R18, R24: 100k; R_Axial_DIN0207_L6.3mm_D2.5mm_P7.62mm_Horizontal
R3, R5: 2.2k_0.1%; R_Axial_DIN0207_L6.3mm_D2.5mm_P7.62mm_Horizontal
R4, R6: 4.7k_0.1%; R_Axial_DIN0207_L6.3mm_D2.5mm_P7.62mm_Horizontal
R7: 47k_1%; R_Axial_DIN0207_L6.3mm_D2.5mm_P7.62mm_Horizontal
R8: 330R_1%; R_Axial_DIN0207_L6.3mm_D2.5mm_P7.62mm_Horizontal
R9: 27k_1%; R_Axial_DIN0207_L6.3mm_D2.5mm_P7.62mm_Horizontal
R10: 1.2k_1%; R_Axial_DIN0207_L6.3mm_D2.5mm_P7.62mm_Horizontal
R11: 56k_1%; R_Axial_DIN0207_L6.3mm_D2.5mm_P7.62mm_Horizontal
R14, R15: 30k_0.1%; R_Axial_DIN0207_L6.3mm_D2.5mm_P7.62mm_Horizontal
R16, R17: 10k_0.1%; R_Axial_DIN0207_L6.3mm_D2.5mm_P7.62mm_Horizontal
R19: 240R_1%; R_Axial_DIN0207_L6.3mm_D2.5mm_P7.62mm_Horizontal
R20: 2.64k_1%; R_Axial_DIN0207_L6.3mm_D2.5mm_P7.62mm_Horizontal
R21, R22: 10k_1%; R_Axial_DIN0207_L6.3mm_D2.5mm_P7.62mm_Horizontal
R23: 8.2R_10W_NonInductive; R_Axial_Power_L25.0mm_W9.0mm_P30.48mm
RV1: 50k_RevLog_MIC_GAIN; Potentiometer_Bourns_3386P_Vertical
RV2: 10k_Log_MIC_VOL; Potentiometer_Bourns_3386P_Vertical
RV3: 10k_Log_LINE_VOL; Potentiometer_Bourns_3386P_Vertical
SW1: DPDT_MODE_SELECT; SW_CK_JS202011CQN_DPDT_Straight
SW2: CONTOUR_BYPASS; SW_DIP_SPSTx01_Slide_6.7x4.1mm_W7.62mm_P2.54mm_LowProfile
TP1: TP_MODE_STATUS; TestPoint_Pad_D1.5mm
U1, U2, U3: NE5532P; DIP-8_W7.62mm
U4: LM317HVT; TO-220-3_Vertical

Connections:
+15V: C3.1, C16.1, C20.1, C21.1, C26.1, D2.2 (A), D3.1 (K), R19.1, R21.1, SW1.4 (D), U1.8 (V+), U2.8 (V+), U3.8 (V+), U4.2 (VO)
+36V: C17.1, C18.1, D1.1 (K), D2.1 (K), J4.1, Q1.3 (S), U4.3 (VI)
AMP_INPUT_SIG: C14.2, J5.1, R24.1
AMP_OUT_NEG: J6.2, J7.2
AMP_OUT_POS: C24.1, J6.1, L1.1, R23.1, SW2.1
DC_FUSE_OUT: F1.2, Q1.2 (D)
DC_IN_RAW: F1.1, J3.1
GND: C1.1, C2.2, C3.2, C10.1, C11.2, C16.2, C17.2, C18.2, C19.2, C20.2, C21.2, C22.2, C23.2, C25.2, C26.2, J3.2, J4.2, J5.2, R1.1, R2.2, R12.1, R13.2, R18.2, R20.2, R22.2, R24.2, RV2.3, RV3.3, SW1.6 (F), U1.4 (V-), U2.4 (V-), U3.4 (V-)
GND_CHASSIS: J1.1, J2.1, J5.3
HPF_MID_NODE: C8.2, C9.1, R9.2
HPF_NONINV: C9.2, R11.1, U2.3 (+)
HPF_OUT: C14.1, R9.1, U2.1, U2.2 (-)
LINE_COLD_AC: C13.1, R15.2
LINE_COLD_RAW: C11.1, C13.2, J2.3, R13.1
LINE_HOT_AC: C12.2, R14.1
LINE_HOT_RAW: C10.2, C12.1, J2.2, R12.2
LINE_REC_INV: R15.1, R17.1, U2.6 (-)
LINE_REC_NONINV: R14.2, R16.2, U2.5 (+)
LINE_REC_OUT: C15.1, R17.2, U2.7
LINE_VOL_POT_IN: C15.2, RV3.1
LM317_ADJ: C19.1, D3.2 (A), R19.2, R20.1, U4.1 (ADJ)
MIC_COLD_AC: C5.1, R5.2
MIC_COLD_RAW: C2.1, C5.2, J1.3, R2.1
MIC_GAIN_POT_CW: R10.2, RV1.1
MIC_HOT_AC: C4.2, R3.1
MIC_HOT_RAW: C1.2, C4.1, J1.2, R1.2
MIC_PRE1_INV: R5.1, R6.1, U1.2 (-)
MIC_PRE1_NONINV: R3.2, R4.2, U1.3 (+)
MIC_PRE2_INV: R8.1, R10.1, U1.6 (-)
MIC_PRE_OUT: C7.1, RV1.2, RV1.3, U1.7
MIC_STG1_OUT: C6.1, R6.2, U1.1
MIC_STG2_IN: C6.2, R7.1, U1.5 (+)
MIC_VOL_POT_IN: C7.2, RV2.1
MODE_A_MIC_SIG: RV2.2, SW1.1 (A)
MODE_B_LINE_SIG: RV3.2, SW1.3 (C)
MODE_STATUS: SW1.5 (E), TP1.1
PMOS_GATE: D1.2 (A), Q1.1 (G), R18.1
SELECTED_AUDIO: C8.1, SW1.2 (B)
SPARE_OUT: U3.6 (-), U3.7
SPK_OUT_POS: C24.2, J7.1, L1.2, R23.2, SW2.2
VBIAS_7V5: C23.1, C25.1, R4.1, R7.2, R8.2, R11.2, R16.1, U3.1, U3.2 (-), U3.5 (+)
VBIAS_DIV: C22.1, R21.2, R22.1, U3.3 (+)

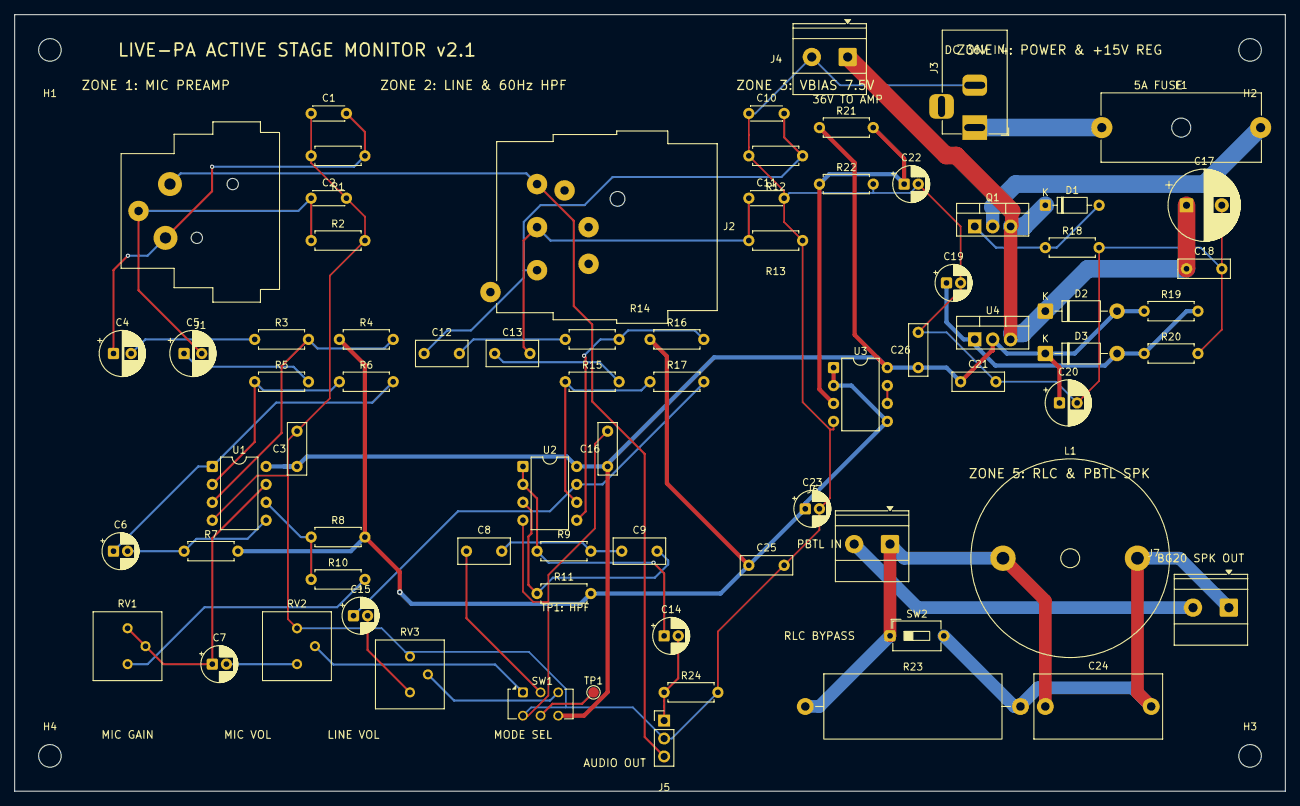
[picture p4: board live-pa-system.kicad_pcb from above]

Board: 2 copper layers, 180.0 x 110.0 mm, 77 parts (0 on the bottom side), 42 nets.

Other parts of the board:
H1, H2, H3, H4: MountingHole_3.2mm_M3
