KawaiButa/speaker-diy/projects/live-pa-system_backup_gate_d/live-pa-system.kicad_sch

## KiCad design projects/live-pa-system_backup_gate_d/live-pa-system.kicad_sch (2026-10-15)

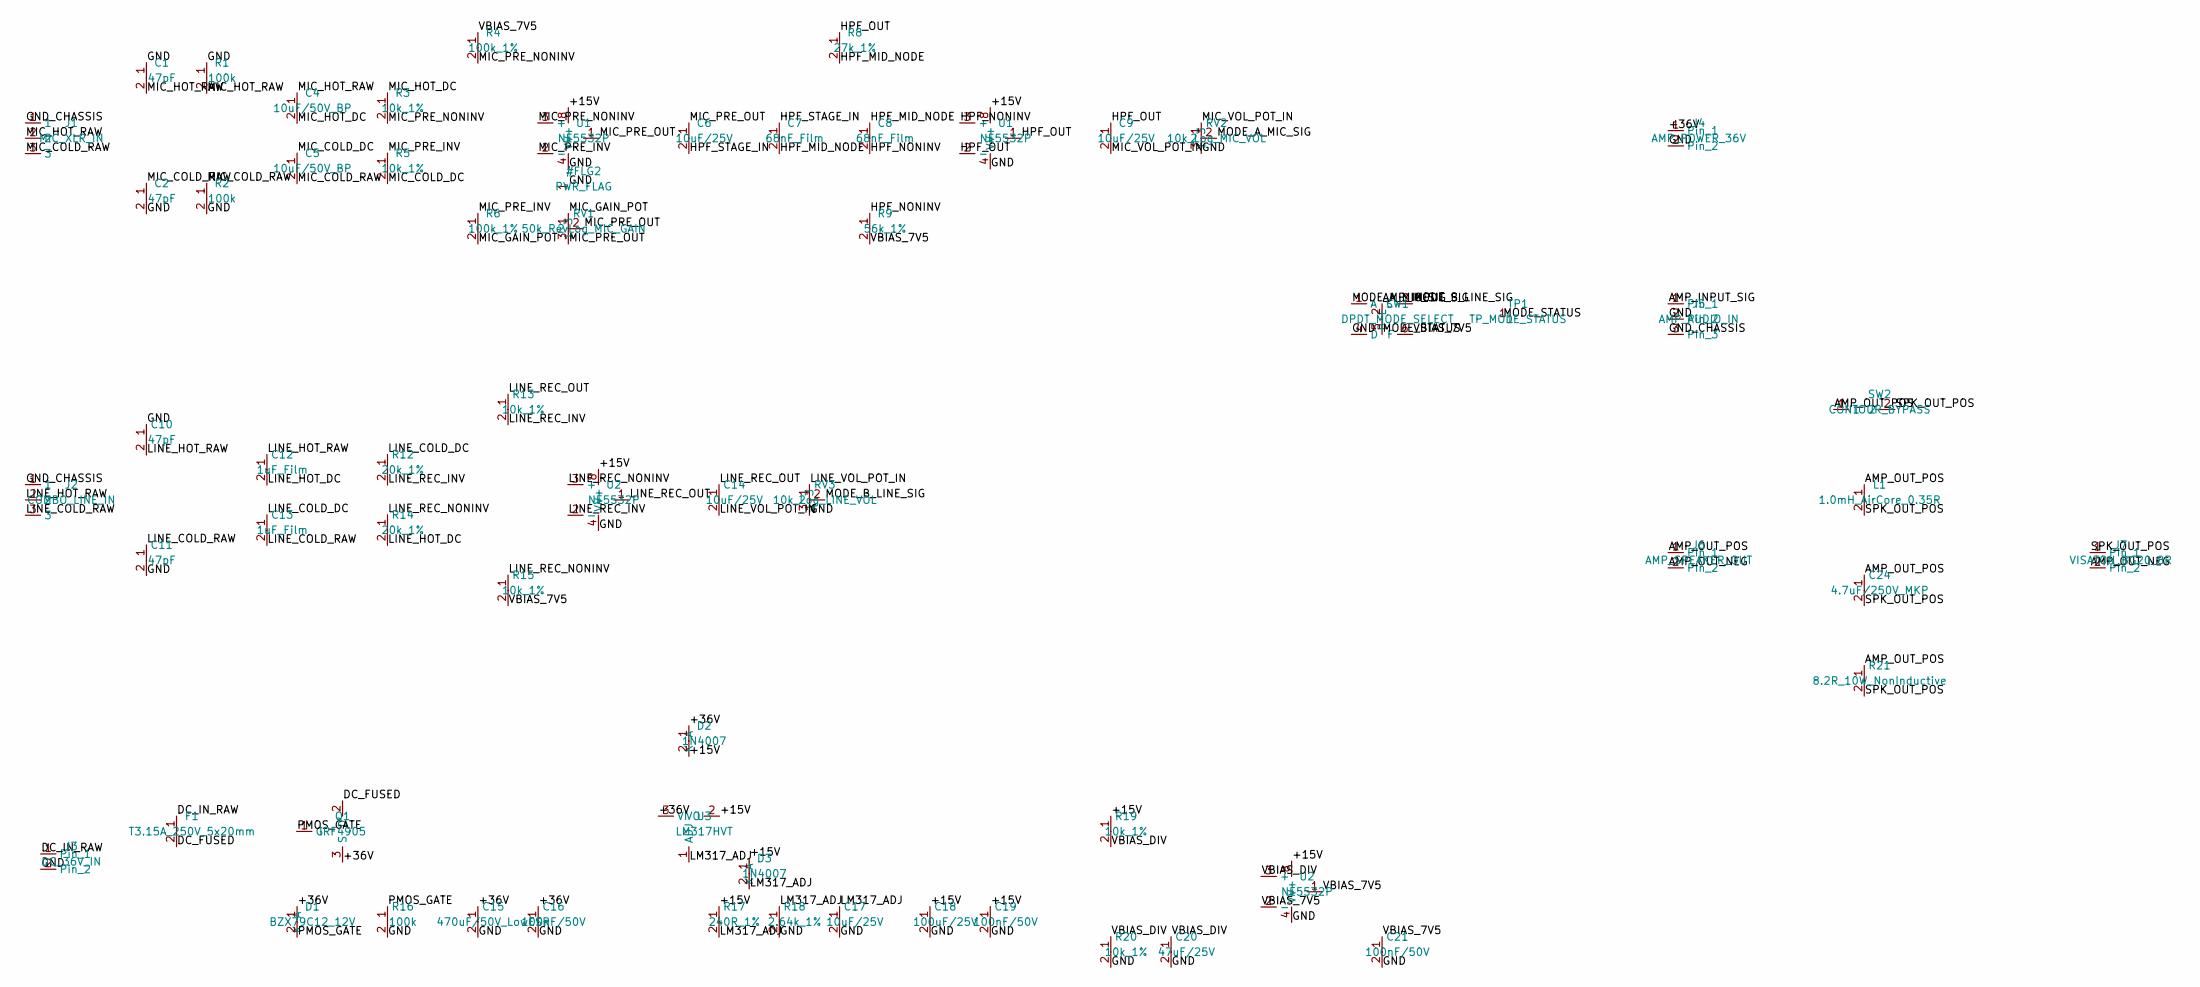
[picture p5: schematic live-pa-system.kicad_sch]

Parts:
C1, C2, C10, C11: 47pF; C_Disc_D4.3mm_W1.9mm_P5.00mm
C4, C5: 10uF/50V_BP; CP_Radial_D6.3mm_P2.50mm
C6, C9, C14, C17: 10uF/25V; CP_Radial_D5.0mm_P2.00mm
C7, C8: 68nF_Film; C_Rect_L7.2mm_W3.5mm_P5.00mm_FKS2_FKP2_MKS2_MKP2
C12, C13: 1uF_Film; C_Rect_L7.2mm_W3.5mm_P5.00mm_FKS2_FKP2_MKS2_MKP2
C15: 470uF/50V_LowESR; CP_Radial_D10.0mm_P5.00mm
C16, C19, C21: 100nF/50V; C_Rect_L7.2mm_W2.5mm_P5.00mm_FKS2_FKP2_MKS2_MKP2
C18: 100uF/25V; CP_Radial_D6.3mm_P2.50mm
C20: 47uF/25V; CP_Radial_D5.0mm_P2.00mm
C24: 4.7uF/250V_MKP; C_Rect_L18.0mm_W9.0mm_P15.00mm_FKS3_FKP3
D1: BZX79C12_12V; D_DO-35_SOD27_P7.62mm_Horizontal
D2, D3: 1N4007; D_DO-41_SOD81_P10.16mm_Horizontal
F1: T3.15A_250V_5x20mm; Fuseholder_Cylinder-5x20mm_Schurter_0031_8201_Horizontal_Op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
J1: MIC_XLR_IN; Neutrik_NC3FAAH2_Horizontal
J2: COMBO_LINE_IN; Neutrik_NCJ6FI-V_Horizontal
J3: DC_36V_IN; BarrelJack_Horizontal
J4: AMP_POWER_36V; TerminalBlock_Phoenix_MKDS-1,5-2-5.08_1x02_P5.08mm_Horizont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
J5: AMP_AUDIO_IN; PinHeader_1x03_P2.54mm_Vertical
J6: AMP_SPEAKER_OUT; TerminalBlock_Phoenix_MKDS-1,5-2-5.08_1x02_P5.08mm_Horizont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
J7: VISATON_BG20_8R; TerminalBlock_Phoenix_MKDS-1,5-2-5.08_1x02_P5.08mm_Horizont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
L1: 1.0mH_AirCore_0.35R; L_Radial_D25.0mm_P15.00mm
Q1: IRF4905; TO-220-3_Vertical
R1, R2, R16: 100k; R_Axial_DIN0207_L6.3mm_D2.5mm_P7.62mm_Horizontal
R3, R5, R13, R15, R19, R20: 10k_1%; R_Axial_DIN0207_L6.3mm_D2.5mm_P7.62mm_Horizontal
R4, R6: 100k_1%; R_Axial_DIN0207_L6.3mm_D2.5mm_P7.62mm_Horizontal
R8: 27k_1%; R_Axial_DIN0207_L6.3mm_D2.5mm_P7.62mm_Horizontal
R9: 56k_1%; R_Axial_DIN0207_L6.3mm_D2.5mm_P7.62mm_Horizontal
R12, R14: 20k_1%; R_Axial_DIN0207_L6.3mm_D2.5mm_P7.62mm_Horizontal
R17: 240R_1%; R_Axial_DIN0207_L6.3mm_D2.5mm_P7.62mm_Horizontal
R18: 2.64k_1%; R_Axial_DIN0207_L6.3mm_D2.5mm_P7.62mm_Horizontal
R21: 8.2R_10W_NonInductive; R_Axial_Power_L25.0mm_D9.0mm_P30.00mm_Horizontal
RV1: 50k_RevLog_MIC_GAIN; Potentiometer_Bourns_3386P_Vertical
RV2: 10k_Log_MIC_VOL; Potentiometer_Bourns_3386P_Vertical
RV3: 10k_Log_LINE_VOL; Potentiometer_Bourns_3386P_Vertical
SW1: DPDT_MODE_SELECT; SW_MEC_5G
SW2: CONTOUR_BYPASS; SW_MEC_5G
TP1: TP_MODE_STATUS; TestPoint_Pad_D1.5mm
U1, U2: NE5532P; DIP-8_W7.62mm
U3: LM317HVT; TO-220-3_Vertical

Connections:
+15V: C18.1, C19.1, D2.2 (A), D3.1 (K), R17.1, R19.1, U1.8 (V+), U2.8 (V+), U3.2 (VO)
+36V: C15.1, C16.1, D1.1 (K), D2.1 (K), J4.1, Q1.3 (S), U3.3 (VI)
AMP_INPUT_SIG: J5.1, SW1.2 (B)
AMP_OUT_NEG: J6.2, J7.2
AMP_OUT_POS: C24.1, J6.1, L1.1, R21.1, SW2.1
DC_FUSED: F1.2, Q1.2 (D)
DC_IN_RAW: F1.1, J3.1
GND: C1.1, C2.2, C10.1, C11.2, C15.2, C16.2, C17.2, C18.2, C19.2, C20.2, C21.2, J3.2, J4.2, J5.2, R1.1, R2.2, R16.2, R18.2, R20.2, RV2.3, RV3.3, SW1.4 (D), U1.4 (V-), U2.4 (V-)
GND_CHASSIS: J1.1, J2.1, J5.3
HPF_MID_NODE: C7.2, C8.1, R8.2
HPF_NONINV: C8.2, R9.1, U1.3 (+)
HPF_OUT: C9.1, R8.1, U1.1, U1.2 (-)
HPF_STAGE_IN: C6.2, C7.1
LINE_COLD_DC: C13.1, R12.1
LINE_COLD_RAW: C11.1, C13.2, J2.3
LINE_HOT_DC: C12.2, R14.2
LINE_HOT_RAW: C10.2, C12.1, J2.2
LINE_REC_INV: R12.2, R13.2, U2.2 (-)
LINE_REC_NONINV: R14.1, R15.1, U2.3 (+)
LINE_REC_OUT: C14.1, R13.1, U2.1
LINE_VOL_POT_IN: C14.2, RV3.1
LM317_ADJ: C17.1, D3.2 (A), R17.2, R18.1, U3.1 (ADJ)
MIC_COLD_DC: C5.1, R5.2
MIC_COLD_RAW: C2.1, C5.2, J1.3, R2.1
MIC_GAIN_POT: R6.2, RV1.1
MIC_HOT_DC: C4.2, R3.1
MIC_HOT_RAW: C1.2, C4.1, J1.2, R1.2
MIC_PRE_INV: R5.1, R6.1, U1.2 (-)
MIC_PRE_NONINV: R3.2, R4.2, U1.3 (+)
MIC_PRE_OUT: C6.1, RV1.2, RV1.3, U1.1
MIC_VOL_POT_IN: C9.2, RV2.1
MODE_A_MIC_SIG: RV2.2, SW1.1 (A)
MODE_B_LINE_SIG: RV3.2, SW1.3 (C)
MODE_STATUS: SW1.5 (E), TP1.1
PMOS_GATE: D1.2 (A), Q1.1 (G), R16.1
SPK_OUT_POS: C24.2, J7.1, L1.2, R21.2, SW2.2
VBIAS_7V5: C21.1, R4.1, R9.2, R15.2, SW1.6 (F), U2.1, U2.2 (-)
VBIAS_DIV: C20.1, R19.2, R20.1, U2.3 (+)
