KawaiButa/speaker-diy/(notices)

Notices in the files:
README.md:
License: MIT
